frodegill/Drivhus/README.md

# Drivhus
Replacement for MiniDrivhus. This repository is for schematic for PCB and sourcecode for Arduino for a fullscale greenhouse irrigation system for up to 15 plants per Arduino
