frodegill/Drivhus/drivhus_pcb/drivhus_pcb.kicad_pcb

## KiCad design drivhus_pcb/drivhus_pcb.kicad_pcb (2025-03-18)

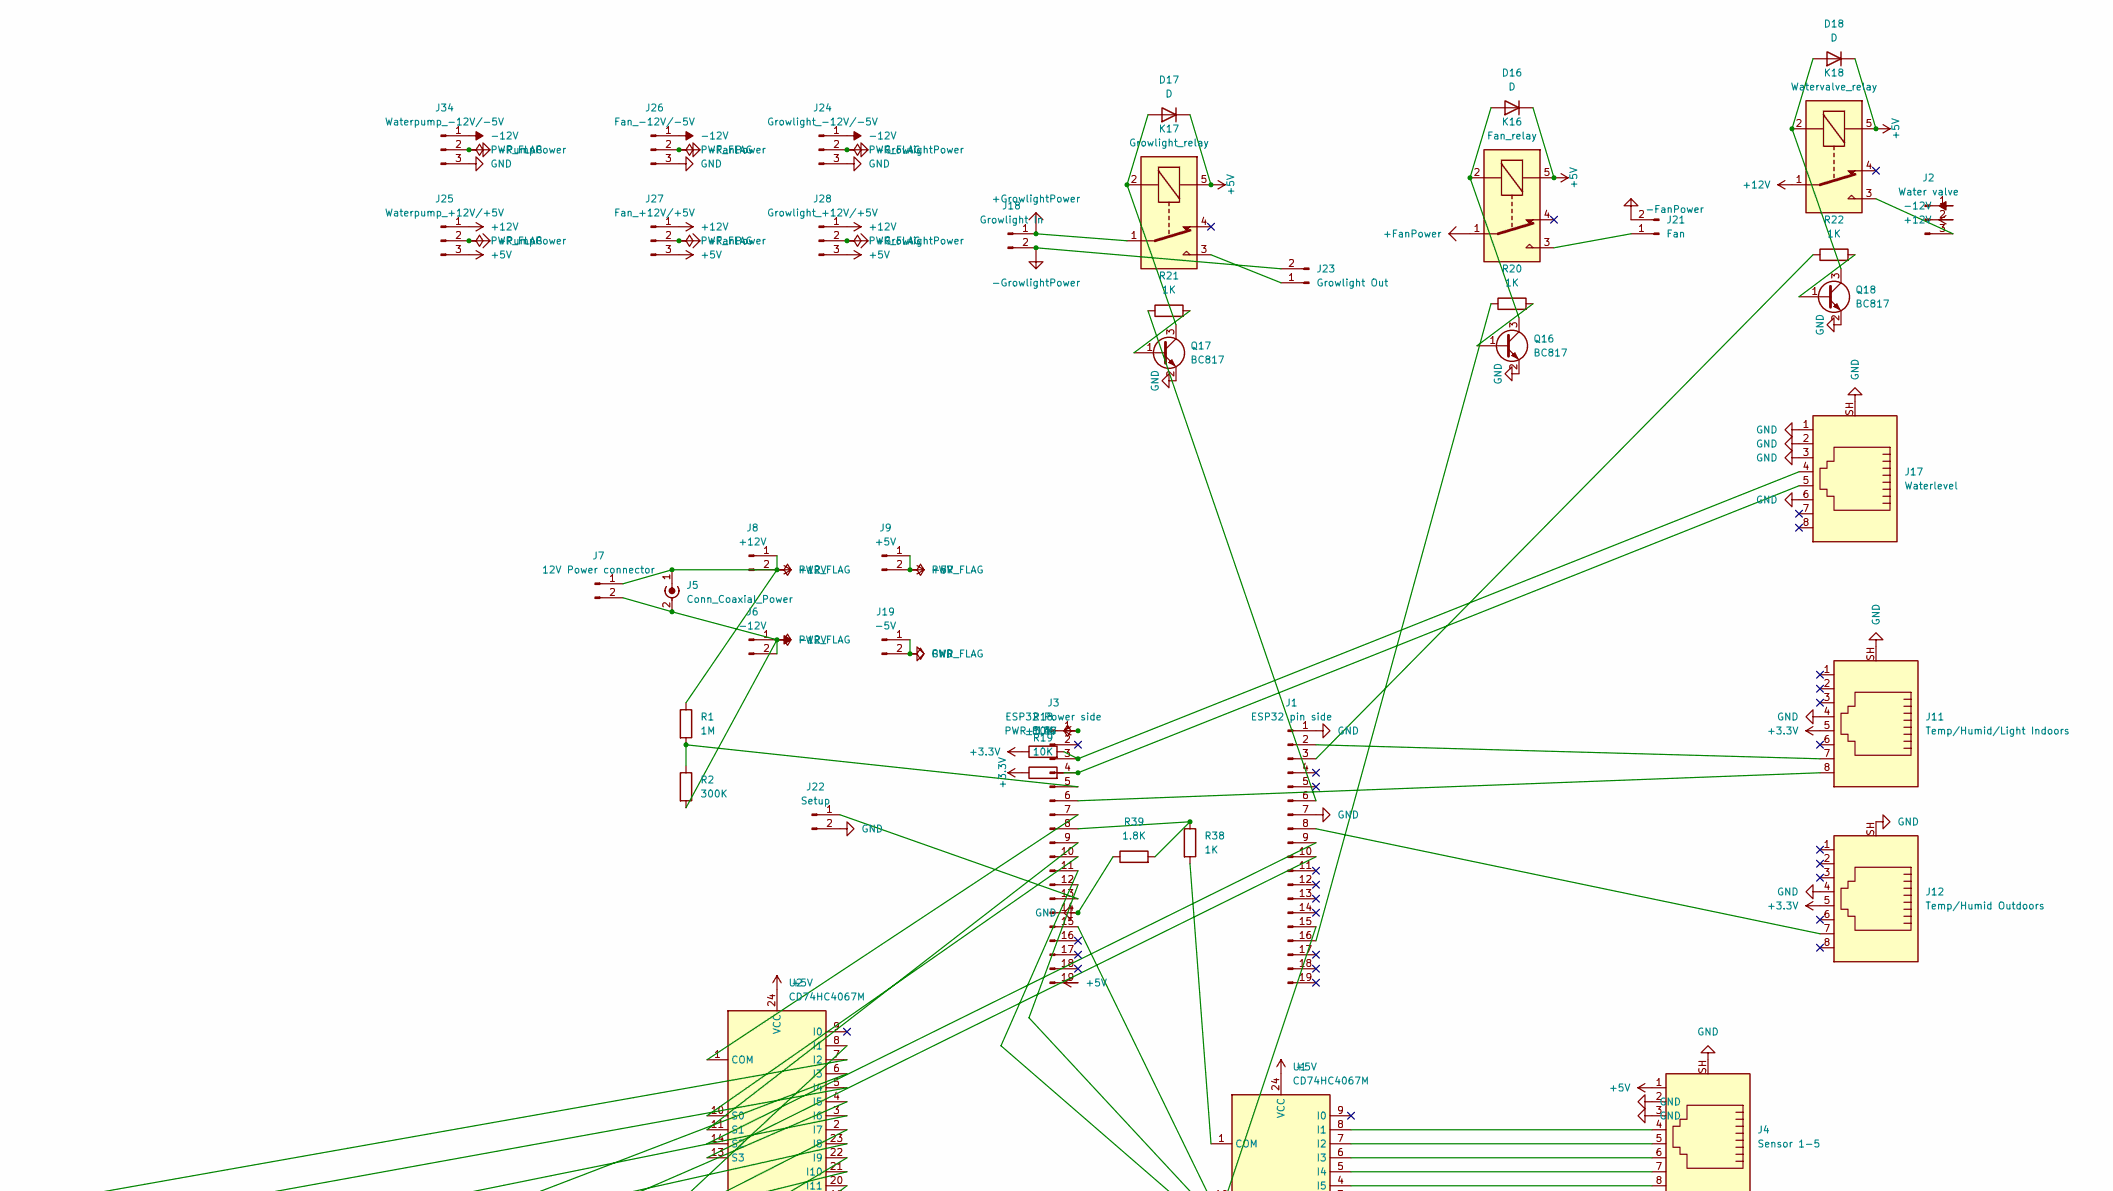
[picture p1: schematic drivhus_pcb.kicad_sch, part in row 1, column 2]

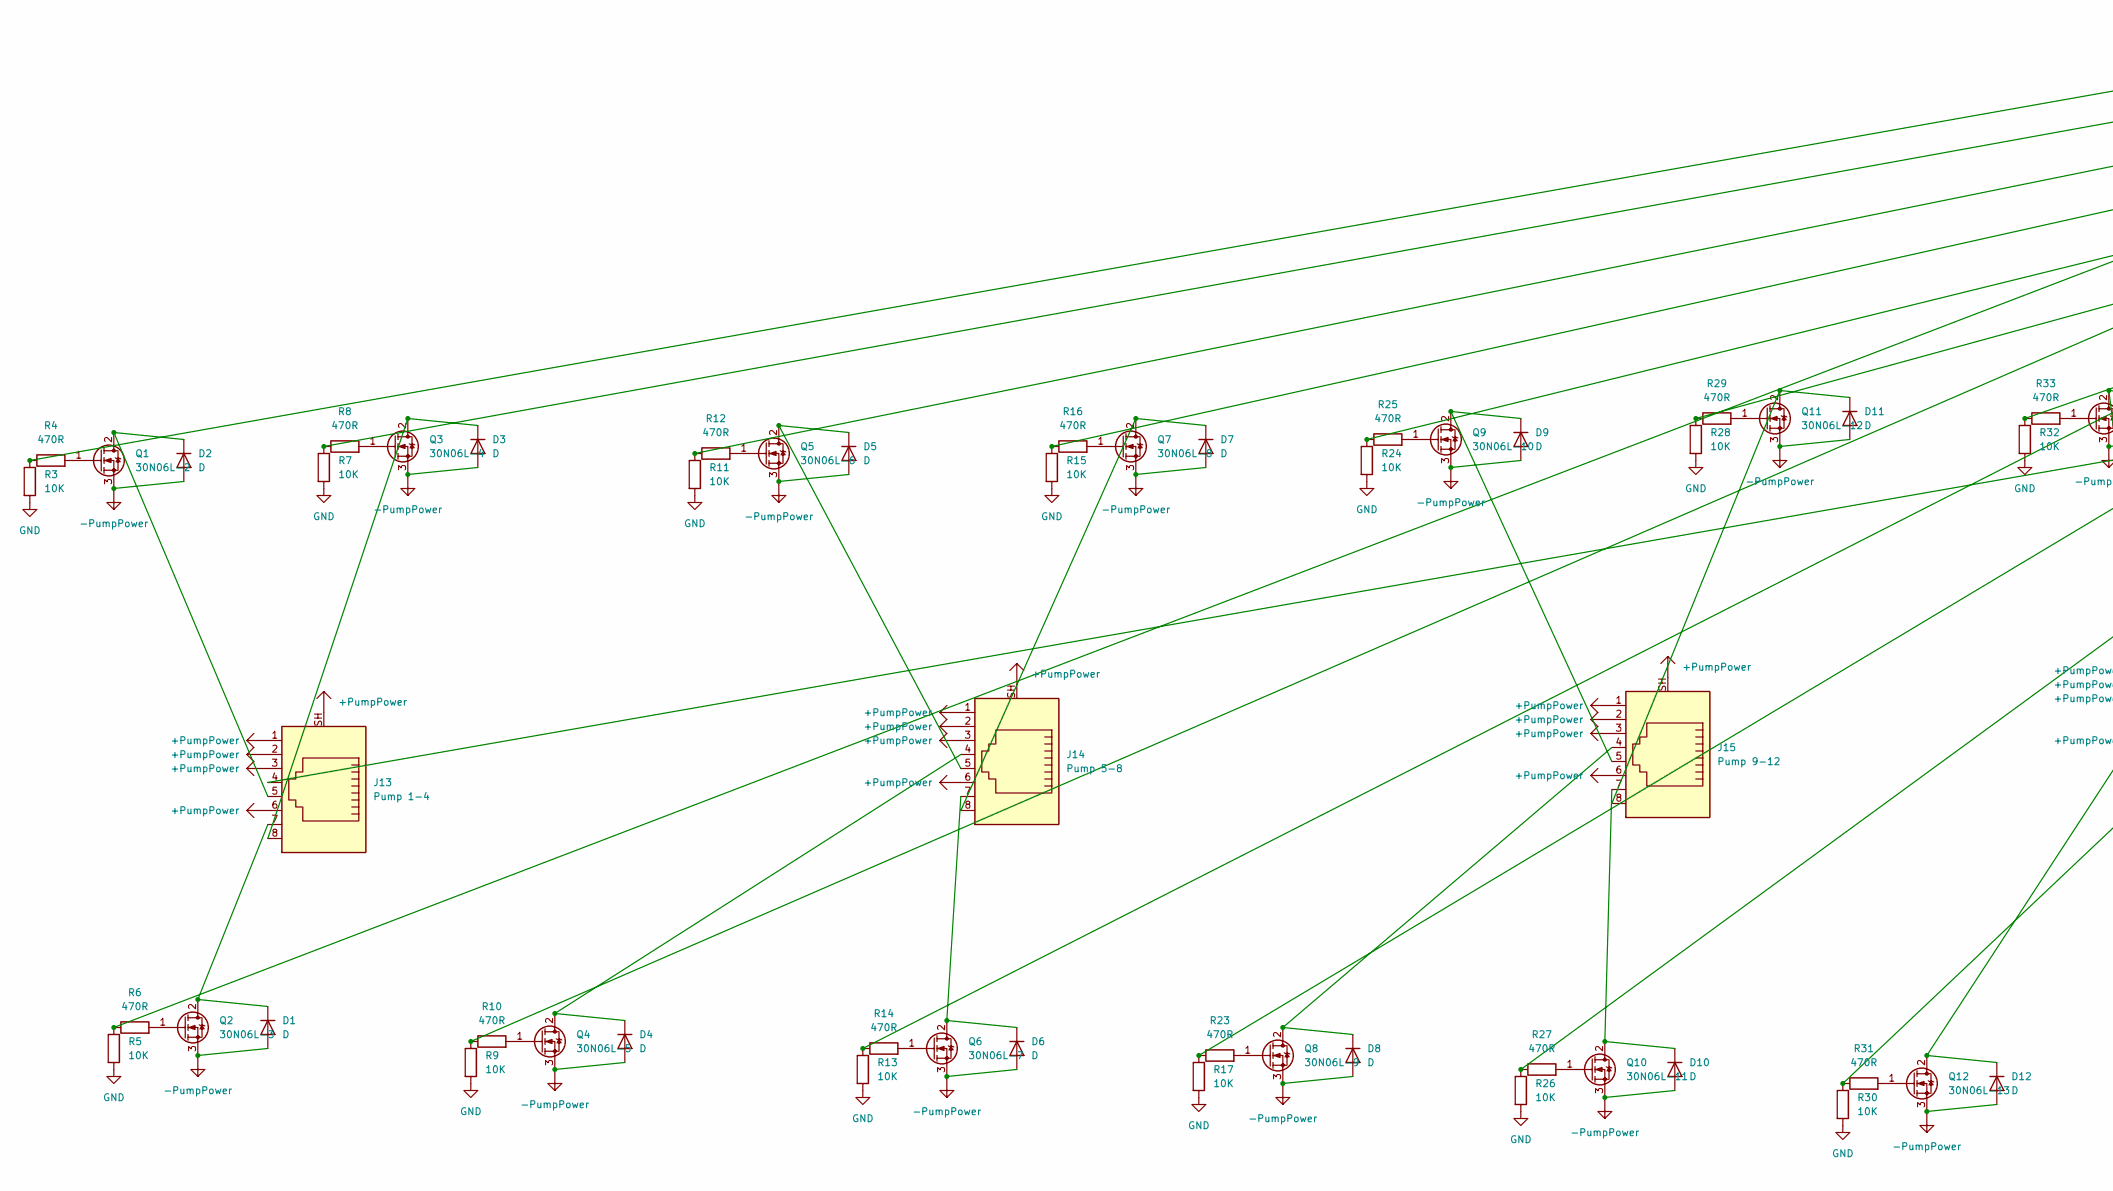
[picture p2: schematic drivhus_pcb.kicad_sch, part in row 2, column 1]

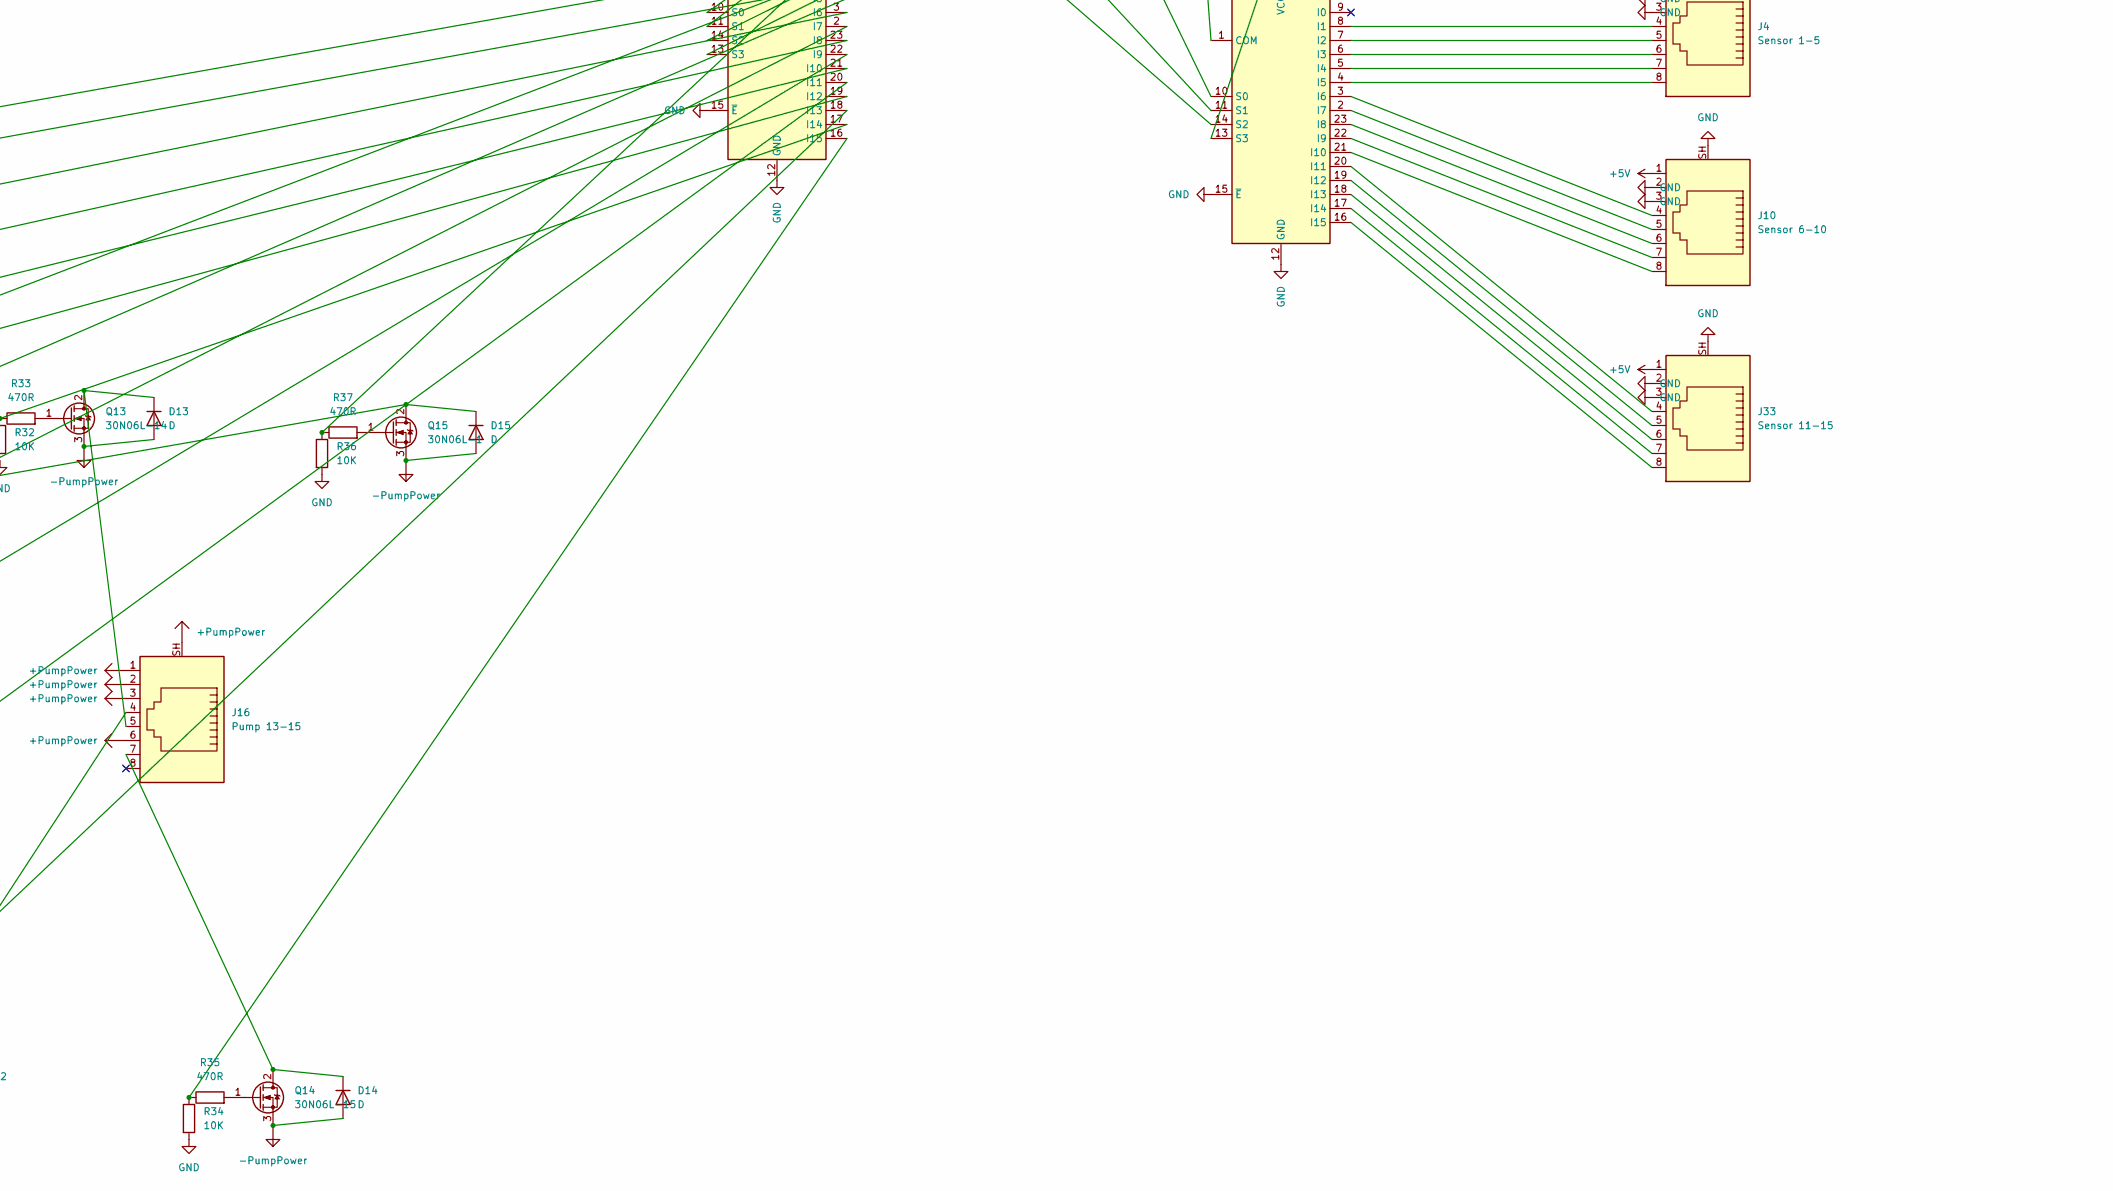
[picture p3: schematic drivhus_pcb.kicad_sch, part in row 2, column 2]

Parts:
D1, D2, D3, D4, D5, D6, D7, D8, D9, D10, D11, D12, D13, D14, D15, D16, D17, D18: D; D_SMB
J1: ESP32 pin side; PinHeader_1x19_P2.54mm_Vertical
J2: Water valve; TerminalBlock_bornier-3_P5.08mm
J3: ESP32 Power side; PinHeader_1x19_P2.54mm_Vertical
J4: Sensor 1-5; RJ45_Ninigi_GE
J5: Conn_Coaxial_Power; BarrelJack_Wuerth_6941xx301002
J6: -12V; PinHeader_1x02_P2.54mm_Vertical
J7: 12V Power connector; TerminalBlock_bornier-2_P5.08mm
J8: +12V; PinHeader_1x02_P2.54mm_Vertical
J9: +5V; PinHeader_1x02_P2.54mm_Vertical
J10: Sensor 6-10; RJ45_Ninigi_GE
J11: Temp/Humid/Light Indoors; RJ45_Ninigi_GE
J12: Temp/Humid Outdoors; RJ45_Ninigi_GE
J13: Pump 1-4; RJ45_Ninigi_GE
J14: Pump 5-8; RJ45_Ninigi_GE
J15: Pump 9-12; RJ45_Ninigi_GE
J16: Pump 13-15; RJ45_Ninigi_GE
J17: Waterlevel; RJ45_Ninigi_GE
J18: Growlight In; TerminalBlock_bornier-2_P5.08mm
J19: -5V; PinHeader_1x02_P2.54mm_Vertical
J21: Fan; TerminalBlock_bornier-2_P5.08mm
J22: Setup; PinHeader_1x02_P2.54mm_Vertical
J23: Growlight Out; TerminalBlock_bornier-2_P5.08mm
J24: Growlight_-12V/-5V; PinHeader_1x03_P2.54mm_Vertical
J25: Waterpump_+12V/+5V; PinHeader_1x03_P2.54mm_Vertical
J26: Fan_-12V/-5V; PinHeader_1x03_P2.54mm_Vertical
J27: Fan_+12V/+5V; PinHeader_1x03_P2.54mm_Vertical
J28: Growlight_+12V/+5V; PinHeader_1x03_P2.54mm_Vertical
J33: Sensor 11-15; RJ45_Ninigi_GE
J34: Waterpump_-12V/-5V; PinHeader_1x03_P2.54mm_Vertical
K16: Fan_relay; Relay_SPDT_SANYOU_SRD_Series_Form_C
K17: Growlight_relay; Relay_SPDT_SANYOU_SRD_Series_Form_C
K18: Watervalve_relay; Relay_SPDT_SANYOU_SRD_Series_Form_C
Q1: 30N06L-2; TO-252-2
Q2: 30N06L-3; TO-252-2
Q3: 30N06L-4; TO-252-2
Q4: 30N06L-5; TO-252-2
Q5: 30N06L-6; TO-252-2
Q6: 30N06L-7; TO-252-2
Q7: 30N06L-8; TO-252-2
Q8: 30N06L-9; TO-252-2
Q9: 30N06L-10; TO-252-2
Q10: 30N06L-11; TO-252-2
Q11: 30N06L-12; TO-252-2
Q12: 30N06L-13; TO-252-2
Q13: 30N06L-14; TO-252-2
Q14: 30N06L-15; TO-252-2
Q15: 30N06L-1; TO-252-2
Q16, Q17, Q18: BC817; SOT-23
R1: 1M; R_1206_3216Metric
R2: 300K; R_1206_3216Metric
R3, R5, R7, R9, R11, R13, R15, R17, R18, R19, R24, R26, R28, R30, R32, R34, R36: 10K; R_1206_3216Metric
R4, R6, R8, R10, R12, R14, R16, R23, R25, R27, R29, R31, R33, R35, R37: 470R; R_1206_3216Metric
R20, R21, R22, R38: 1K; R_1206_3216Metric
R39: 1.8K; R_1206_3216Metric
U1, U2: CD74HC4067M; SOIC-24W_7.5x15.4mm_P1.27mm

Connections:
+3.3V: J3.1, J11.5, J12.5, R18.1, R19.1
+5V: D16.1 (K), D17.1 (K), D18.1 (K), J3.19, J4.1, J9.1, J9.2, J10.1, J25.3, J27.3, J28.3, J33.1, K16.5, K17.5, K18.5, U1.24 (VCC), U2.24 (VCC)
+12V: J2.2, J5.1 (In), J7.1, J8.1, J8.2, J25.1, J27.1, J28.1, K18.1, R1.1
+FanPower: J27.2, K16.1
+GrowlightPower: J18.1, J28.2, K17.1
-12V: J2.1, J5.2 (Ext), J6.1, J6.2, J7.2, J24.1, J26.1, J34.1, R2.2
-FanPower: J21.2, J26.2
-GrowlightPower: J18.2, J23.2, J24.2
-PumpPower: D1.2 (A), D2.2 (A), D3.2 (A), D4.2 (A), D5.2 (A), D6.2 (A), D7.2 (A), D8.2 (A), D9.2 (A), D10.2 (A), D11.2 (A), D12.2 (A), D13.2 (A), D14.2 (A), D15.2 (A), J34.2, Q1.3 (S), Q2.3 (S), Q3.3 (S), Q4.3 (S), Q5.3 (S), Q6.3 (S), Q7.3 (S), Q8.3 (S), Q9.3 (S), Q10.3 (S), Q11.3 (S), Q12.3 (S), Q13.3 (S), Q14.3 (S), Q15.3 (S)
unnamed: D1.1 (K), J13.7, Q2.2 (D)
unnamed: D2.1 (K), J13.5, Q1.2 (D)
unnamed: D3.1 (K), J13.8, Q3.2 (D)
unnamed: D4.1 (K), J14.4, Q4.2 (D)
unnamed: D5.1 (K), J14.5, Q5.2 (D)
unnamed: D6.1 (K), J14.7, Q6.2 (D)
unnamed: D8.1 (K), J15.4, Q8.2 (D)
unnamed: D9.1 (K), J15.5, Q9.2 (D)
unnamed: D10.1 (K), J15.7, Q10.2 (D)
unnamed: D12.1 (K), J16.4, Q12.2 (D)
unnamed: D14.1 (K), J16.7, Q14.2 (D)
unnamed: D16.2 (A), K16.2, Q16.3 (C)
unnamed: D17.2 (A), K17.2, Q17.3 (C)
unnamed: D18.2 (A), K18.2, Q18.3 (C)
unnamed: J1.2, J11.7
unnamed: J1.3, R22.1
unnamed: J1.6, R21.1
unnamed: J1.8, J12.7
unnamed: J1.9, U2.14 (S2)
unnamed: J1.10, U2.13 (S3)
unnamed: J1.15, U1.13 (S3)
unnamed: J1.16, R20.1
unnamed: J2.3, K18.3
unnamed: J3.3, J17.4, R18.2
unnamed: J3.4, J17.5, R19.2
unnamed: J3.5, R1.2, R2.1
unnamed: J3.6, J11.8
unnamed: J3.7, U2.1 (COM)
unnamed: J3.8, R38.1, R39.2
unnamed: J3.9, U2.11 (S1)
unnamed: J3.10, U2.10 (S0)
unnamed: J3.11, U1.14 (S2)
unnamed: J3.12, U1.11 (S1)
unnamed: J3.15, U1.10 (S0)
unnamed: J21.1, K16.3
unnamed: J3.13, J22.1
unnamed: J23.1, K17.3
unnamed: Q1.1 (G), R4.2
unnamed: Q2.1 (G), R6.2
unnamed: Q3.1 (G), R8.2
unnamed: Q4.1 (G), R10.2
unnamed: Q5.1 (G), R12.2
unnamed: Q6.1 (G), R14.2
unnamed: Q7.1 (G), R16.2
unnamed: Q8.1 (G), R23.2
unnamed: Q9.1 (G), R25.2
unnamed: Q10.1 (G), R27.2
unnamed: Q11.1 (G), R29.2
unnamed: Q12.1 (G), R31.2
unnamed: Q13.1 (G), R33.2
unnamed: Q14.1 (G), R35.2
unnamed: Q15.1 (G), R37.2
unnamed: Q16.1 (B), R20.2
unnamed: Q17.1 (B), R21.2
unnamed: Q18.1 (B), R22.2
unnamed: R38.2, U1.1 (COM)
unnamed: J4.4, U1.8 (I1)
unnamed: J4.5, U1.7 (I2)
unnamed: J4.6, U1.6 (I3)
unnamed: J4.7, U1.5 (I4)
unnamed: J4.8, U1.4 (I5)
unnamed: J10.4, U1.3 (I6)
unnamed: J10.5, U1.2 (I7)
unnamed: J10.6, U1.23 (I8)
unnamed: J10.7, U1.22 (I9)
unnamed: J10.8, U1.21 (I10)
unnamed: J33.4, U1.20 (I11)
unnamed: J33.5, U1.19 (I12)
unnamed: J33.6, U1.18 (I13)
unnamed: J33.7, U1.17 (I14)
unnamed: J33.8, U1.16 (I15)
unnamed: R36.1, R37.1, U2.8 (I1)
unnamed: R3.1, R4.1, U2.7 (I2)
unnamed: R7.1, R8.1, U2.5 (I4)
unnamed: R9.1, R10.1, U2.4 (I5)
unnamed: R11.1, R12.1, U2.3 (I6)
unnamed: R15.1, R16.1, U2.23 (I8)
unnamed: R17.1, R23.1, U2.22 (I9)
unnamed: R24.1, R25.1, U2.21 (I10)
unnamed: R30.1, R31.1, U2.18 (I13)
unnamed: R34.1, R35.1, U2.16 (I15)

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
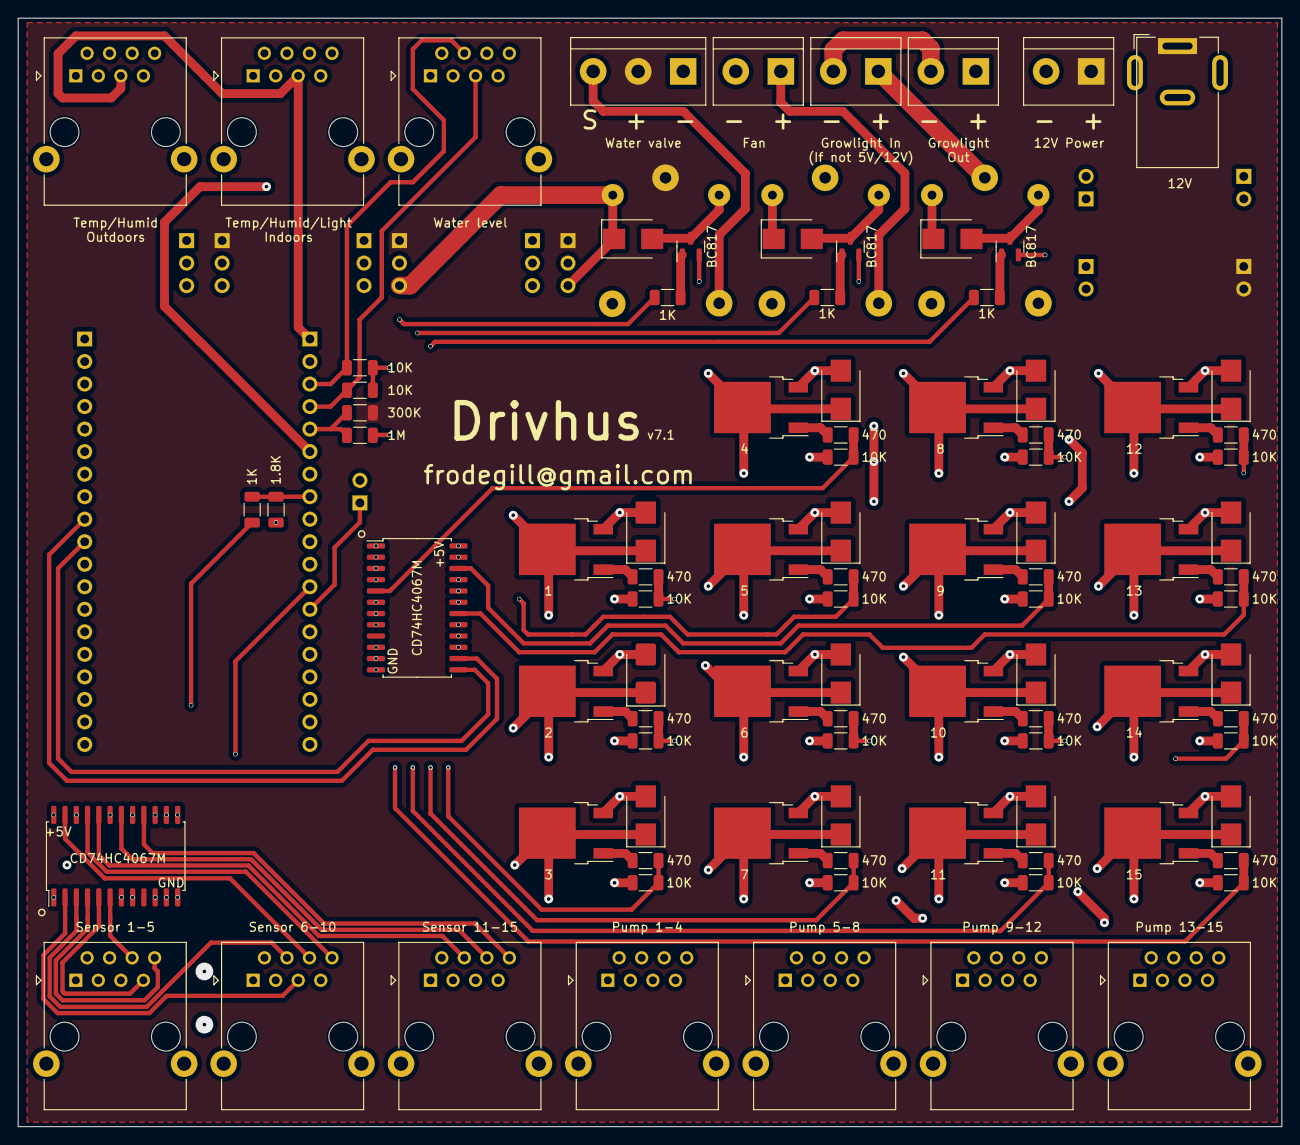
[picture p4: board drivhus_pcb.kicad_pcb from above]

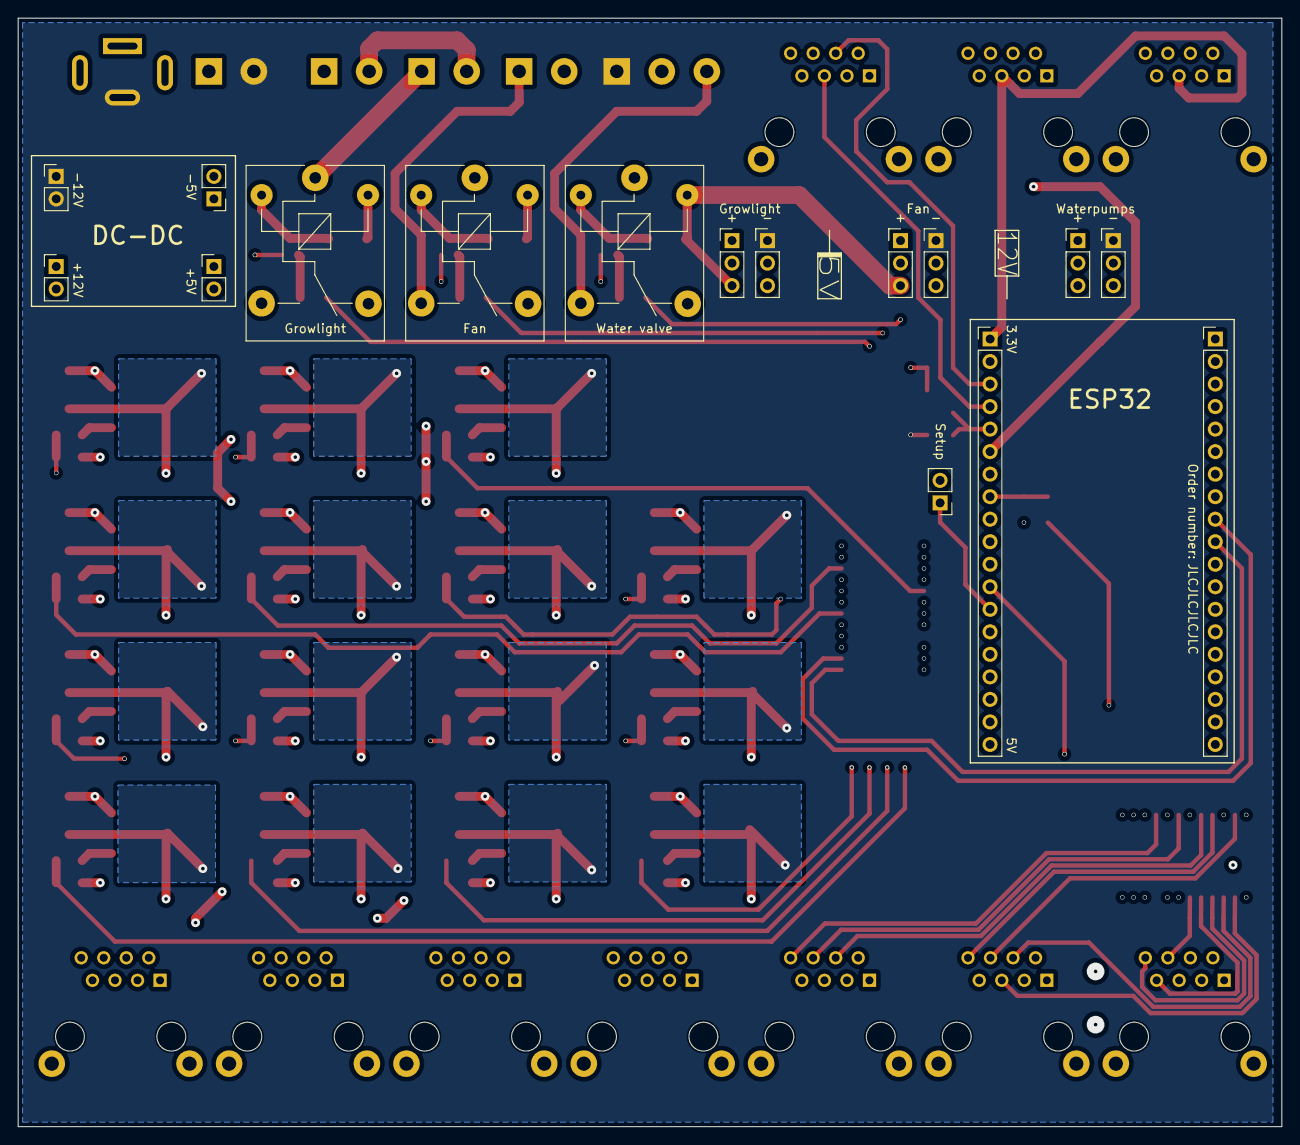
[picture p5: board drivhus_pcb.kicad_pcb from below]

Board: 4 copper layers, 142.5 x 125.0 mm, 109 parts (16 on the bottom side), 101 nets.
