frodegill/Drivhus/sensorconnector_pcb/sensorconnector_pcb.kicad_pcb

## KiCad design sensorconnector_pcb/sensorconnector_pcb.kicad_pcb (2025-01-17)

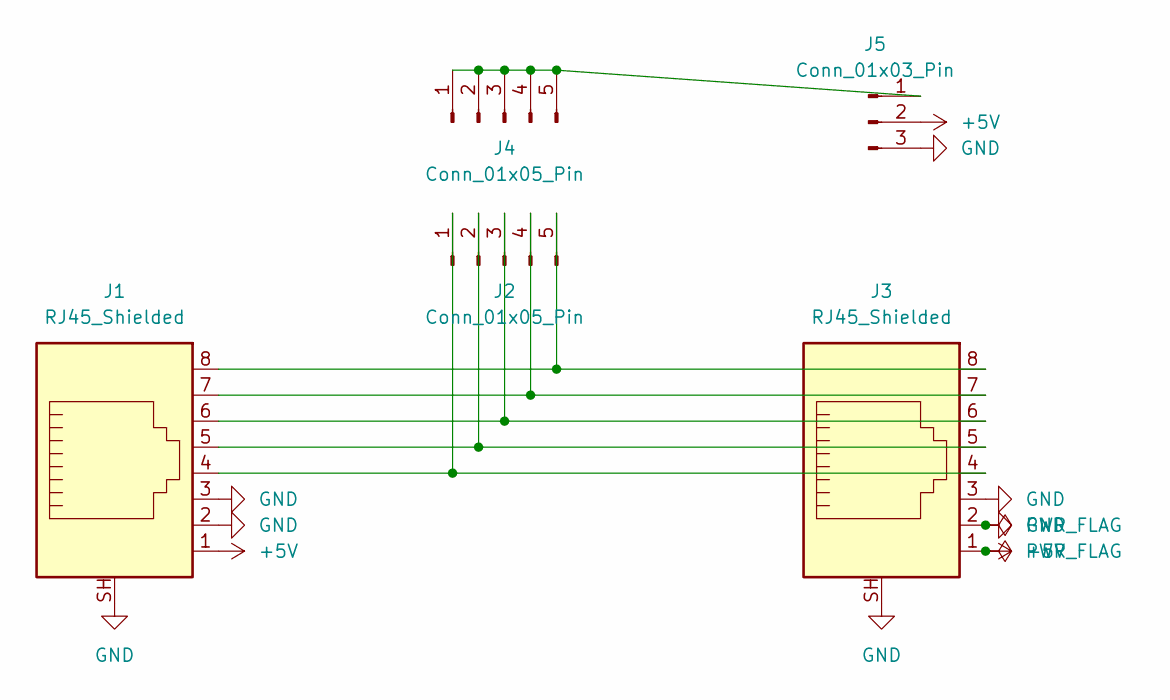
[picture p6: schematic sensorconnector_pcb.kicad_sch]

Parts:
J1, J3: RJ45_Shielded; RJ45_Ninigi_GE
J2, J4: Conn_01x05_Pin; PinHeader_1x05_P2.54mm_Vertical
J5: Conn_01x03_Pin; TerminalBlock_bornier-3_P5.08mm

Connections:
+5V: J1.1, J3.1, J5.2
GND: J1.2, J1.3, J1.SH, J3.2, J3.3, J3.SH, J5.3
unnamed: J1.4, J2.1, J3.4
unnamed: J1.5, J2.2, J3.5
unnamed: J1.6, J2.3, J3.6
unnamed: J1.7, J2.4, J3.7
unnamed: J1.8, J2.5, J3.8
unnamed: J4.1, J4.2, J4.3, J4.4, J4.5, J5.1

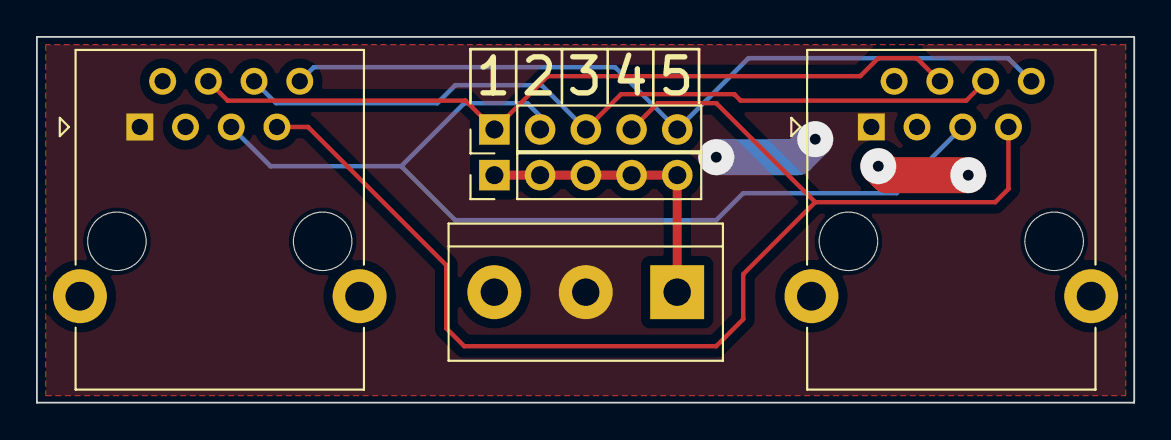
[picture p7: board sensorconnector_pcb.kicad_pcb from above]

Board: 2 copper layers, 61.0 x 20.3 mm, 5 parts (0 on the bottom side), 8 nets.
