frodegill/Drivhus/waterlevelconnector_pcb/waterlevelconnector_pcb.kicad_pcb

## KiCad design waterlevelconnector_pcb/waterlevelconnector_pcb.kicad_pcb (2023-12-08)

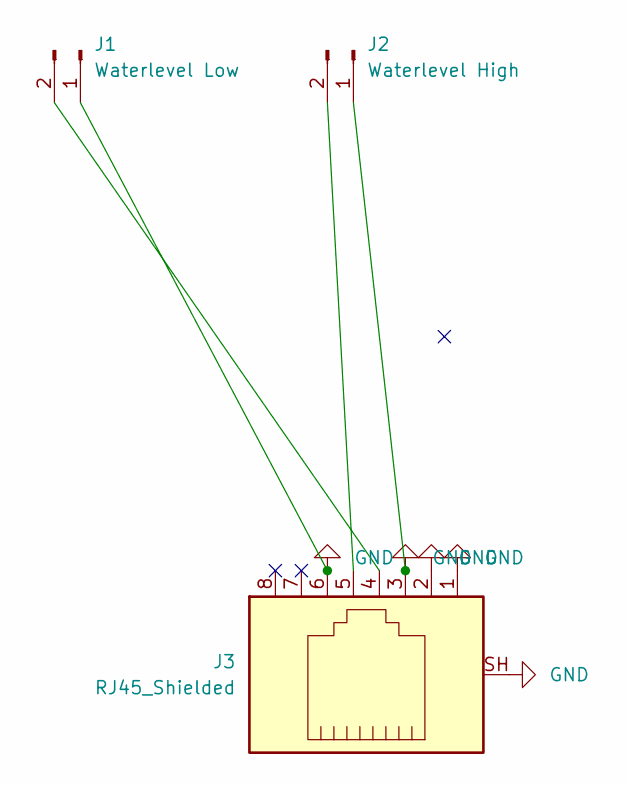
[picture p8: schematic waterlevelconnector_pcb.kicad_sch]

Parts:
J1: Waterlevel Low; TerminalBlock_bornier-2_P5.08mm
J2: Waterlevel High; TerminalBlock_bornier-2_P5.08mm
J3: RJ45_Shielded; RJ45_Ninigi_GE

Connections:
GND: J1.1, J2.1, J3.1, J3.2, J3.3, J3.6, J3.SH
unnamed: J1.2, J3.4
unnamed: J2.2, J3.5

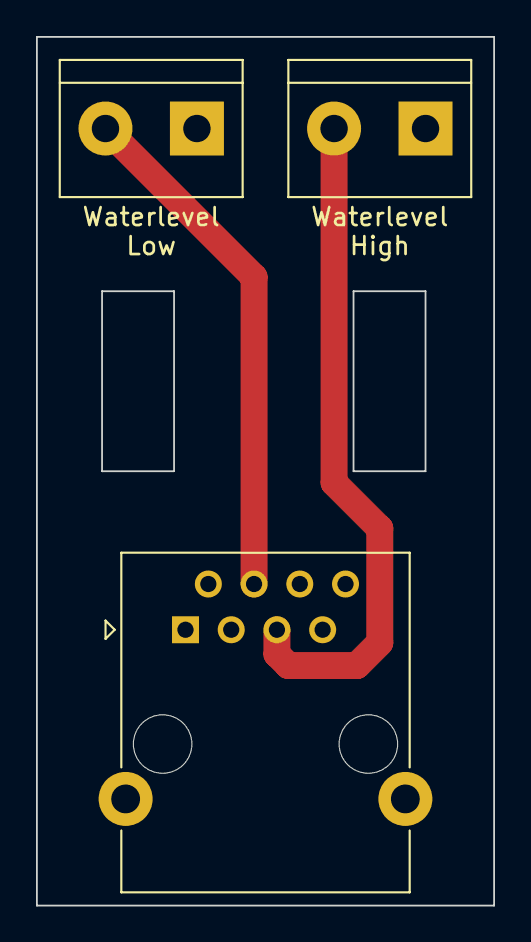
[picture p9: board waterlevelconnector_pcb.kicad_pcb from above]

Board: 2 copper layers, 25.4 x 48.3 mm, 3 parts (0 on the bottom side), 3 nets.
