frodegill/Drivhus/temphumid_pcb/temphumid_pcb.kicad_pcb

## KiCad design temphumid_pcb/temphumid_pcb.kicad_pcb (2023-11-28)

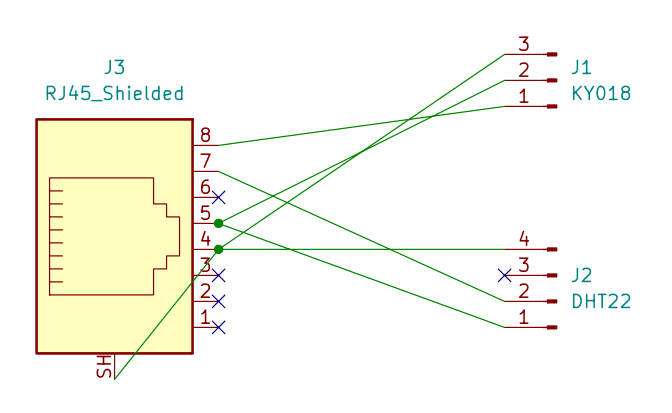
[picture p10: schematic temphumid_pcb.kicad_sch]

Parts:
J1: KY018; PinHeader_1x03_P2.00mm_Vertical
J2: DHT22; AM2302
J3: RJ45_Shielded; RJ45_Ninigi_GE

Connections:
unnamed: J1.3, J2.4, J3.4, J3.SH
unnamed: J1.2, J2.1, J3.5
unnamed: J2.2, J3.7
unnamed: J1.1, J3.8

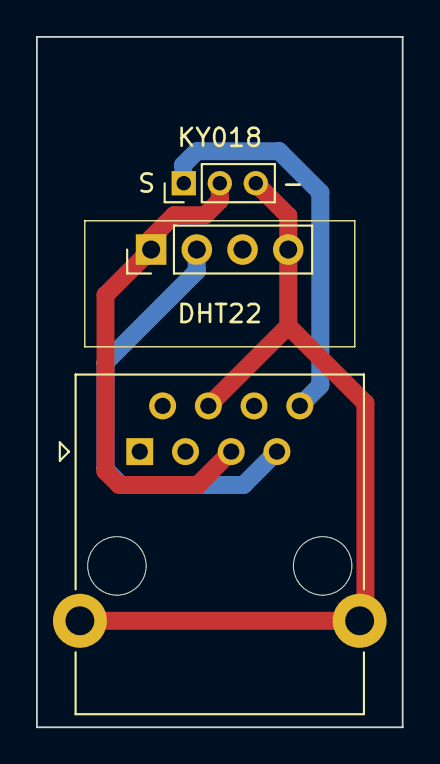
[picture p11: board temphumid_pcb.kicad_pcb from above]

Board: 2 copper layers, 20.3 x 38.4 mm, 3 parts (0 on the bottom side), 4 nets.
