frodegill/Drivhus/drivhus/global.h

#ifndef _GLOBAL_H_
#define _GLOBAL_H_

#ifdef TESTING
# include "testing.h"
#else
# include <Timezone.h>
#endif

#include <memory>
#include <stdint.h>
#include <string>


namespace Drivhus {

#ifndef PI
# define PI (3.1415926535897932384626433832795)
#endif

#define degToRad(angleInDegrees) ((angleInDegrees) * PI / 180.0)
#define radToDeg(angleInRadians) ((angleInRadians) * 180.0 / PI)

static constexpr bool ON = true;
static constexpr bool OFF = false;


static constexpr uint8_t MAX_PLANT_COUNT = 15;

static constexpr uint8_t O_WATERPUMP_CD74HC4067_COMMON_PIN = 32;
static constexpr uint8_t O_WATERPUMP_CD74HC4067_S0_PIN   = 26;
static constexpr uint8_t O_WATERPUMP_CD74HC4067_S1_PIN   = 25;
static constexpr uint8_t O_WATERPUMP_CD74HC4067_S2_PIN   = 18;
static constexpr uint8_t O_WATERPUMP_CD74HC4067_S3_PIN   = 5;
static constexpr uint8_t I_SENSORS_CD74HC4067_COMMON_PIN = 33;
static constexpr uint8_t O_SENSORS_CD74HC4067_S0_PIN   = 13;
static constexpr uint8_t O_SENSORS_CD74HC4067_S1_PIN   = 14;
static constexpr uint8_t O_SENSORS_CD74HC4067_S2_PIN   = 27;
static constexpr uint8_t O_SENSORS_CD74HC4067_S3_PIN   = 2;
static constexpr uint8_t I_DHT22_INDOOR_PIN    = 23;
static constexpr uint8_t I_DHT22_OUTDOOR_PIN   = 19;
static constexpr uint8_t O_FAN_PIN             = 15;
static constexpr uint8_t O_GROWLIGHT_PIN       = 21;
static constexpr uint8_t I_KY018_PIN           = 35;
static constexpr uint8_t I_SETUP_MODE_ENABLE_PIN = 12;
static constexpr uint8_t I_VOLT_PIN            = 34;
static constexpr uint8_t O_WATER_VALVE_PIN     = 22;
static constexpr uint8_t I_WATERLEVEL_LOW_PIN  = 36;
static constexpr uint8_t I_WATERLEVEL_HIGH_PIN = 39;

//A small selection of time zones
struct TimezoneInfo {
  const char code[3+1];
  const char description[25+1];
  const TimeChangeRule regular;
  const TimeChangeRule dst;
};
constexpr TimezoneInfo g_timezones[] = {{"CET", "Central European Time", {"", Last, Sun, Oct, 3, 1*60}, {"", Last, Sun, Mar, 2, 2*60}},
                                        {"BST", "United Kingdom", {"", Last, Sun, Oct, 2, 0*60}, {"", Last, Sun, Mar, 1, 1*60}},
                                        {"EST", "US Eastern Time", {"", First, Sun, Nov, 2, -5*60}, {"", Second, Sun, Mar, 2, -4*60}},
                                        {"PST", "US Pacific Time", {"", First, Sun, Nov, 2, -8*60}, {"", Second, Sun, Mar, 2, -7*60}}};

class Settings;
[[nodiscard]] std::shared_ptr<Settings> getSettings();

class DHT22; //Temperature/Humidity sensor
[[nodiscard]] std::shared_ptr<DHT22> getIndoorDHT22();
[[nodiscard]] std::shared_ptr<DHT22> getOutdoorDHT22();

class Fan;
[[nodiscard]] std::shared_ptr<Fan> getFan();

class Growlight;
[[nodiscard]] std::shared_ptr<Growlight> getGrowlight();

class KY018; //Light sensor
[[nodiscard]] std::shared_ptr<KY018> getKY018();

class Log;
[[nodiscard]] std::shared_ptr<Log> getLog();

class MQTT;
[[nodiscard]] std::shared_ptr<MQTT> getMQTT();

class Network;
[[nodiscard]] std::shared_ptr<Network> getNetwork();

class NTP;
[[nodiscard]] std::shared_ptr<NTP> getNTP();

class SoilSensors;
[[nodiscard]] std::shared_ptr<SoilSensors> getSoilSensors();

class WebServer;
[[nodiscard]] std::shared_ptr<WebServer> getWebServer();

class Volt; //Volt sensor
[[nodiscard]] std::shared_ptr<Volt> getVolt();

class Waterlevel; //Waterlevel sensors
[[nodiscard]] std::shared_ptr<Waterlevel> getWaterlevel();

class WaterPumps;
[[nodiscard]] std::shared_ptr<WaterPumps> getWaterPumps();


[[nodiscard]] const TimezoneInfo* getTimezoneInfo(const std::string& timezone);
[[nodiscard]] std::string floatToString(const float& value, uint8_t precision);
[[nodiscard]] std::string uint8ToHex(uint8_t value);
[[nodiscard]] std::string uint16ToHex(uint16_t value);

} //namespace

#endif // _GLOBAL_H_
