frodegill/Drivhus/drivhus/ky018.h

#ifndef _KY018_H_
#define _KY018_H_

#include <stdint.h>

#include "component.h"


namespace Drivhus {

class KY018 : public Component
{
public:
  static constexpr unsigned long POLL_INTERVAL_MS = 30000;

public:
  KY018(uint8_t pin);
  [[nodiscard]] virtual bool init() override;
  virtual void loop() override;
  virtual const char* getName() const override {return "KY018";}

private:
  uint8_t m_pin;
  unsigned long m_previous_sampling_time;
};

} //namespace

#endif // _KY018_H_
