frodegill/Drivhus/(commit log)

2023-11-04 Added schematics for MAX485
    [drivhus_pcb.kicad_pcb, drivhus_pcb.kicad_sch]
2023-11-15 Added stup mode jumper to schematics
    [drivhus_pcb.kicad_sch]
2023-11-16 Added pins for the DC-DC power
    [drivhus_pcb.kicad_sch]
2023-11-18 Added PCB for sensor connector
    [sensorconnector_pcb.kicad_pcb, sensorconnector_pcb.kicad_sch]
2023-11-18 Use RJ45 as quick-connect for RS-485 bus. Two connectors, so controller can be in the middle of bus
    [drivhus_pcb.kicad_sch]
2023-11-23 Added voltage sensor (max 14.5V)
    [drivhus_pcb.kicad_sch]
2023-11-28 Added connectors for indoor and outdoor temp/humid/light sensors
    [drivhus_pcb.kicad_sch]
2023-11-28 Added PCB for temp/humid/light sensor
    [temphumid_pcb.kicad_pcb, temphumid_pcb.kicad_sch]
2023-11-29 Added updating temp,humidity,light and voltage
2023-11-29 Added support for custom Volt multiplier
2023-12-01 Added some KiCAD gitignores
2023-12-01 Added relays. Added lots and lots of relays...
    [drivhus_pcb.kicad_sch]
2023-12-01 Cleaned up the schematic power lines
    [drivhus_pcb.kicad_sch]
2023-12-03 Added connector for pumps
    [drivhus_pcb.kicad_sch, pumpconnector_pcb.kicad_pcb, pumpconnector_pcb.kicad_sch]
2023-12-08 Added schematics and PCB for waterlevel switches
    [drivhus_pcb.kicad_sch, waterlevelconnector_pcb.kicad_pcb, waterlevelconnector_pcb.kicad_sch]
2023-12-08 Added pins for waterlevel switches
2023-12-10 Added support for waterlevel low/high sensors and water valve
2023-12-13 Added remaining parts and connections to schematics
    [drivhus_pcb.kicad_sch]
2023-12-15 Finished the Drivhus PCB design
    [drivhus_pcb.kicad_sch]
2024-01-07 Added explicit namespace. Also added UI for relay test and placeholder for GPIO Viewer
2024-01-10 Made cd74hc4067 more self-aware, and aded initial support for fan and growlight. Test Relay should work now
2024-01-21 Lots of growlight time related changes. Also changed to more specific listeners, and fixed nasty bug in EEPROM handling of max length strings
    [dht22.cpp, dht22.h, fan.cpp, fan.h, global.cpp, global.h, ky018.cpp, network.cpp]
2024-01-22 Fan and Growlight are logically identical
2024-01-22 Volt and Light sensor are logically identical
2024-02-15 Implemented humidity support for fan
2024-02-15 Cache fan configs
2024-02-21 Show calculated outdoor as indoor humidity. Also some sensor scan refactoring
2024-05-16 Actual implementation of water level triggers and -valve
2024-05-16 Added small project to set RS484 address to stubborn sensors
2024-05-19 Do not water if bucket is empty or plant is disabled
2024-05-19 Clear sensor value when disabeling plant
2024-06-05 Prevent use before init
    [settings.cpp, settings.h]
2024-06-24 Lots of small fixes
    [cd74hc4067.cpp, cd74hc4067.h, log.cpp, log.h, mqtt.cpp, mqtt.h, settings.cpp, settings.h]
2024-06-25 Added fan active status
2024-06-26 Fixed off-by-one error and made switch types more explicit
    [webserver.cpp]
2024-07-03 Fixed problems found while compiling with a more up-to-date compiler
    [drivhus.ino, fan.cpp, growlight.cpp, log.cpp, log.h, mqtt.cpp, mqtt.h]
2024-10-21 Changed to multiplexed analog sensors and MOSFETs
    [drivhus_pcb.kicad_sch]
2025-01-17 Updated to a multiplexed analog humidity sensor connector
    [sensorconnector_pcb.kicad_pcb, sensorconnector_pcb.kicad_sch]
2025-01-17 New revision of main irrigation system PCB
    [drivhus_pcb.kicad_pcb]
2025-03-03 Major rewrite of webserver because of switching back to analog sensors and running out of space on ESP32
2025-03-13 Web UI enable/disable sensor
2025-03-18 Cannot use ADC2 together with WiFi on ESP32
    [drivhus_pcb.kicad_pcb, drivhus_pcb.kicad_sch]
2025-04-20 Fixed disabled active sensor handling
    [mqtt.cpp, settings.cpp, soilsensors.cpp]
2025-04-21 extend water valve open time
